NatThoPNS/Projet-Arduino/README.md

Bienvenue dans le GitHub de notre projet Arduino !
