NatThoPNS/Projet-Arduino/Rapports seances/Rapports Thomas/Rapport séance 4 12_01.pdf

## Projet Arduino: Maison connectée

## Rapport de séance n°4 (12/01/2022)

Par TORDJMAN BOLIS Thomas

- Problème ruban de LED

Aujourd’hui, je devais m’occuper du fonctionnement du volet roulant avec Nathan mais nous avions déjà fini la semaine dernière, entre-temps nous avons eu un problème avec le ruban de LED. 1 patte qui avait déjà été ressoudée s’est décrochée et une autre s’est aussi arrachée, j’ai donc demandé au professeur un autre morceau de ruban de LED.
J’ai mis du temps à le faire marcher car j’avais mal fait les branchements et je me suis rendu compte que 2 lignes de mon code précédent étaient inutile :

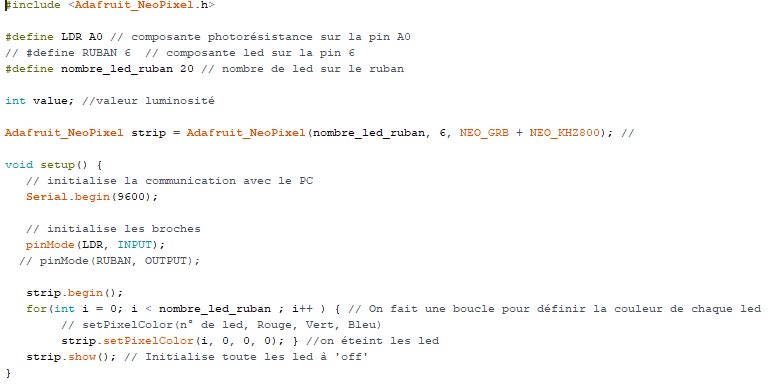
[picture p34: figure]

La variable RUBAN et la fonction pinMode(RUBAN,OUTPUT) sont inutiles car ils servent à attribuer la sortie numérique 6 au ruban mais en réalité, le deuxième argument (« 6 ») de la ligne de code ci-dessous sert déjà à ça.

- Maquette provisoire

En raison de l’oral intermédiaire, nous voulions présenter une maquette plus ou moins fonctionnelle. Nous avons donc décidé de mettre en place la carte arduino et tous les composants dans la maison en carton fabriquée la séance précédente.

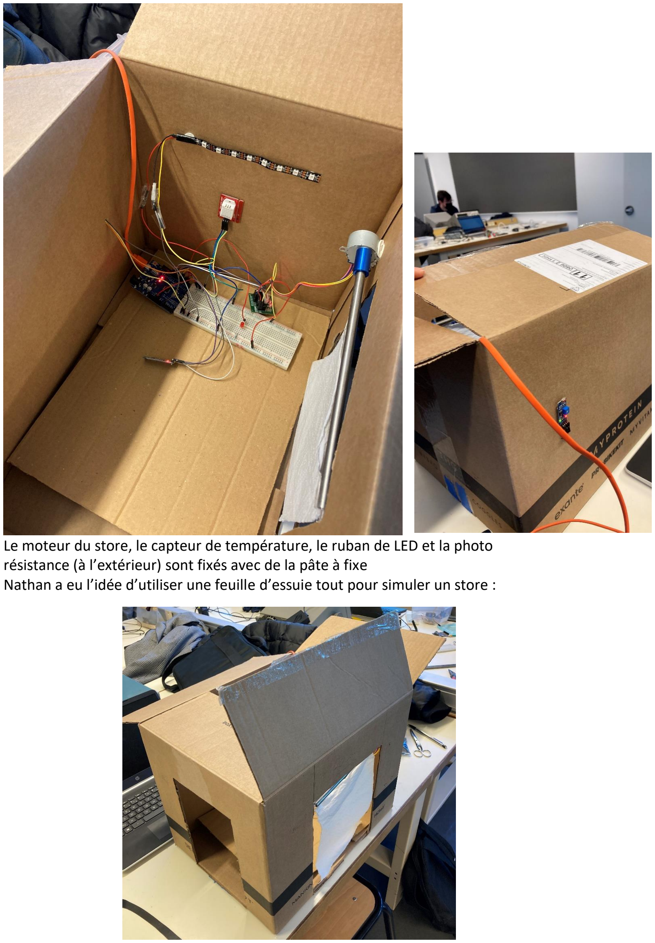
[picture p35: page 2]

Le moteur du store, le capteur de température, le ruban de LED et la photo résistance (à l’extérieur) sont fixés avec de la pâte à fixe
Nathan a eu l’idée d’utiliser une feuille d’essuie tout pour simuler un store :

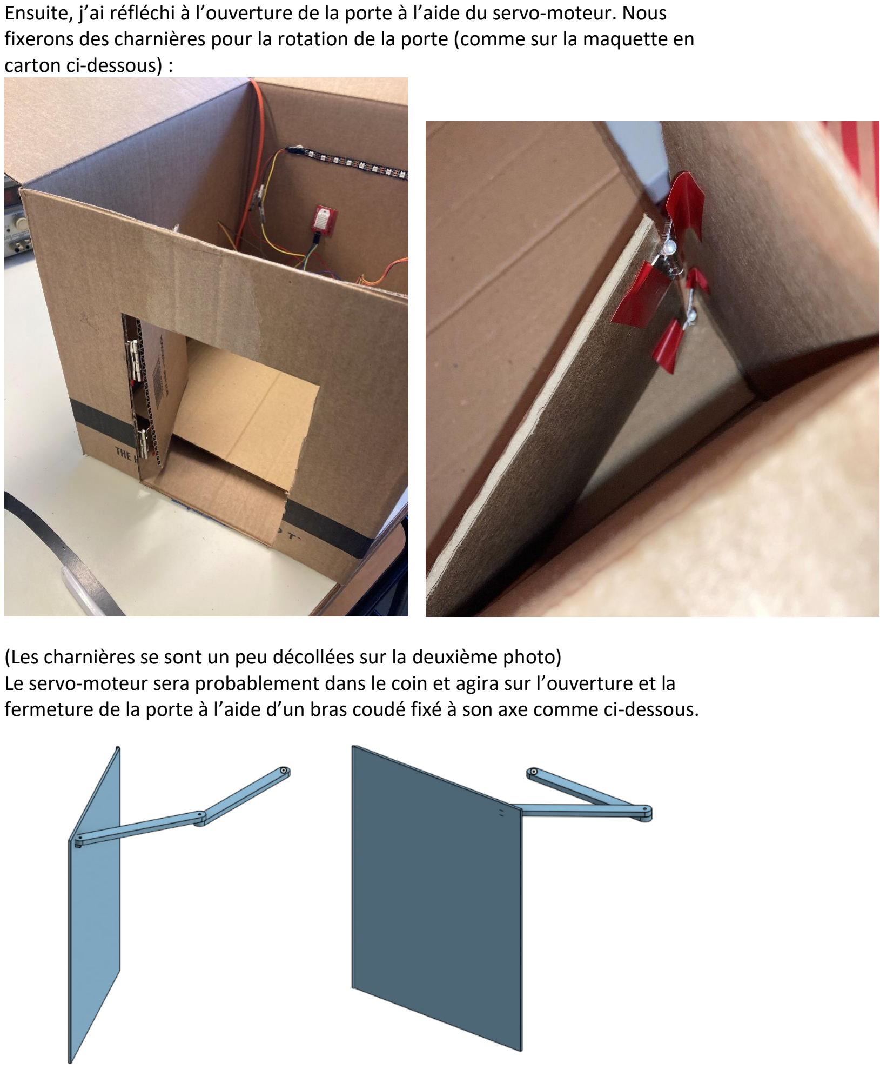
[picture p36: page 3]

Ensuite, j’ai réfléchi à l’ouverture de la porte à l’aide du servo-moteur. Nous fixerons des charnières pour la rotation de la porte (comme sur la maquette en carton ci-dessous) :

(Les charnières se sont un peu décollées sur la deuxième photo)
Le servo-moteur sera probablement dans le coin et agira sur l’ouverture et la fermeture de la porte à l’aide d’un bras coudé fixé à son axe comme ci-dessous.
