NatThoPNS/Projet-Arduino/Rapports seances/Rapports Thomas/Rapport séance 2 15_12.pdf

## Projet Arduino: Maison connectée

## Rapport de séance n°2 (15/12/2021)

Par TORDJMAN BOLIS Thomas

Aujourd’hui, pendant la majorité de la séance je me suis occupé du fonctionnement de l’éclairage de la maison avec le ruban de LED et le module photorésistance, j’ai aussi commencé a m’intéresser au fonctionnement du moteur pas à pas nécessaire au volet roulant.

- Eclairage de la maison :
1. Test du ruban de LED

Voici le code me permettant d’allumer mon ruban de LED en blanc :

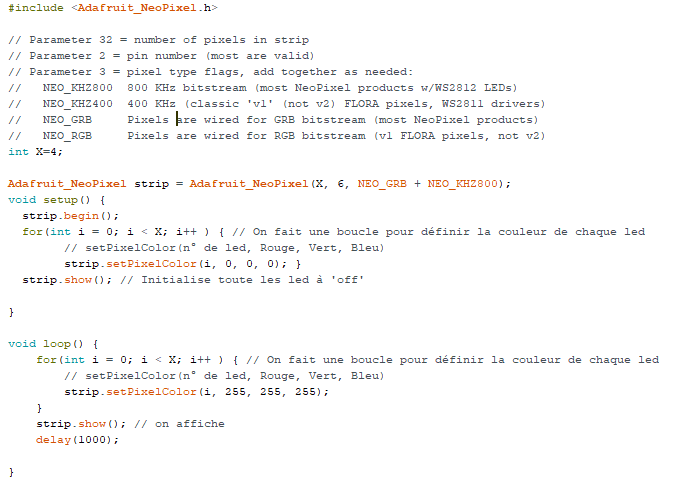
[picture p41: figure]

2. Test du module LDR

J’ai réalisé le montage suivant avec le code ci-dessous pour faire en sorte que la LED rouge s’allume lorsque la luminosité détectée par la LDR descend sous un certain seuil (ici en mettant le doigt sur la photorésistance).

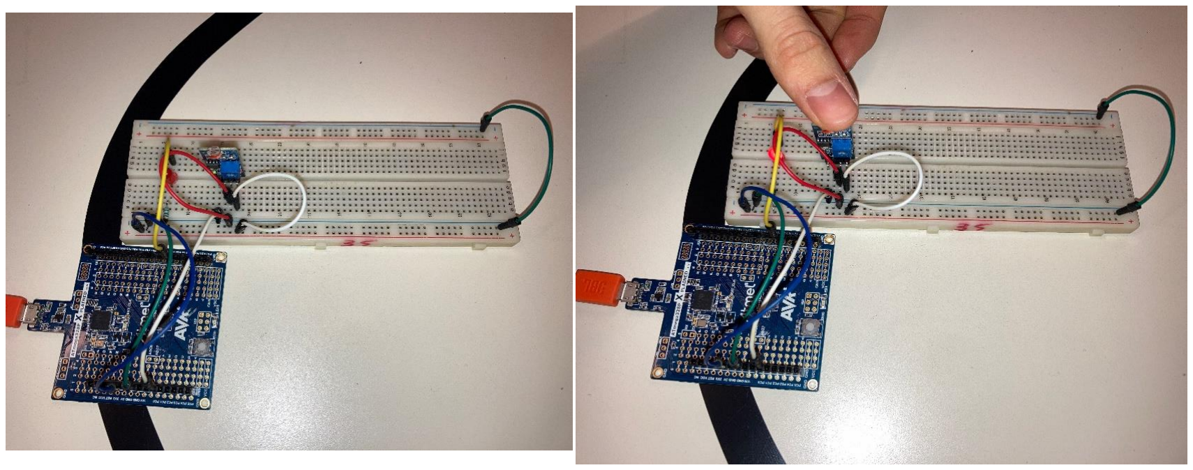
[picture p42: figure]
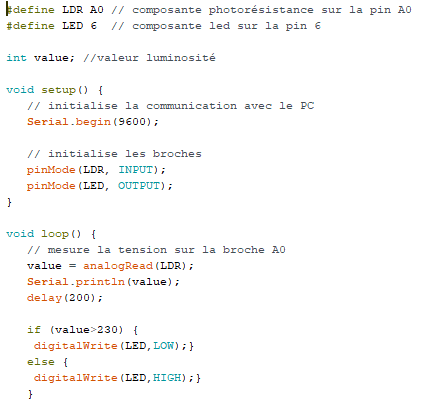
[picture p43: figure]

3. Test final LDR + ruban de LED

Ensuite, j’ai réalisé le montage suivant avec le code ci-dessous pour allumer le ruban de LED en blanc lorsque la luminosité détectée par la photorésistance descend sous un certain seuil (toujours en mettant le doigt dessus).
Le câble vert à droite reliant les deux lignes – est inutile, j’ai oublié de l’enlever après le montage précédent.

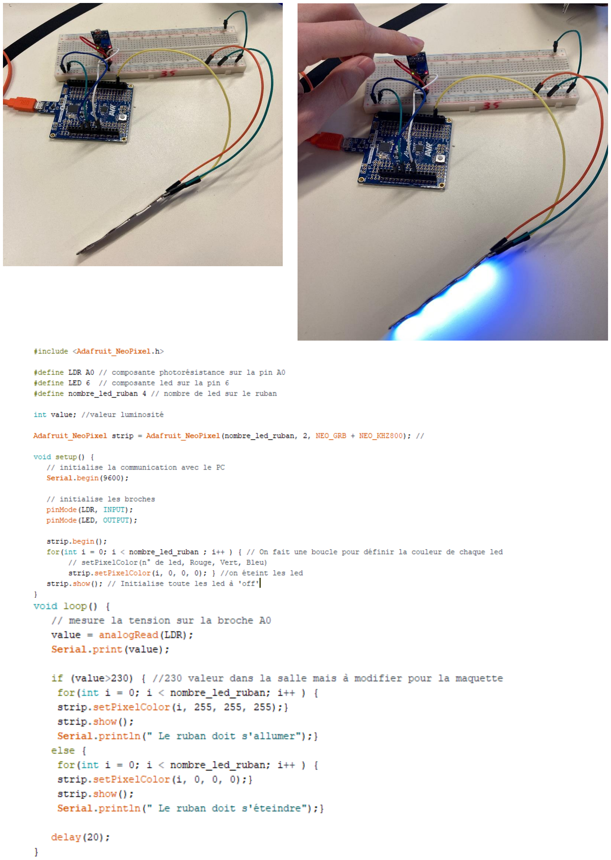
[picture p44: page 3]
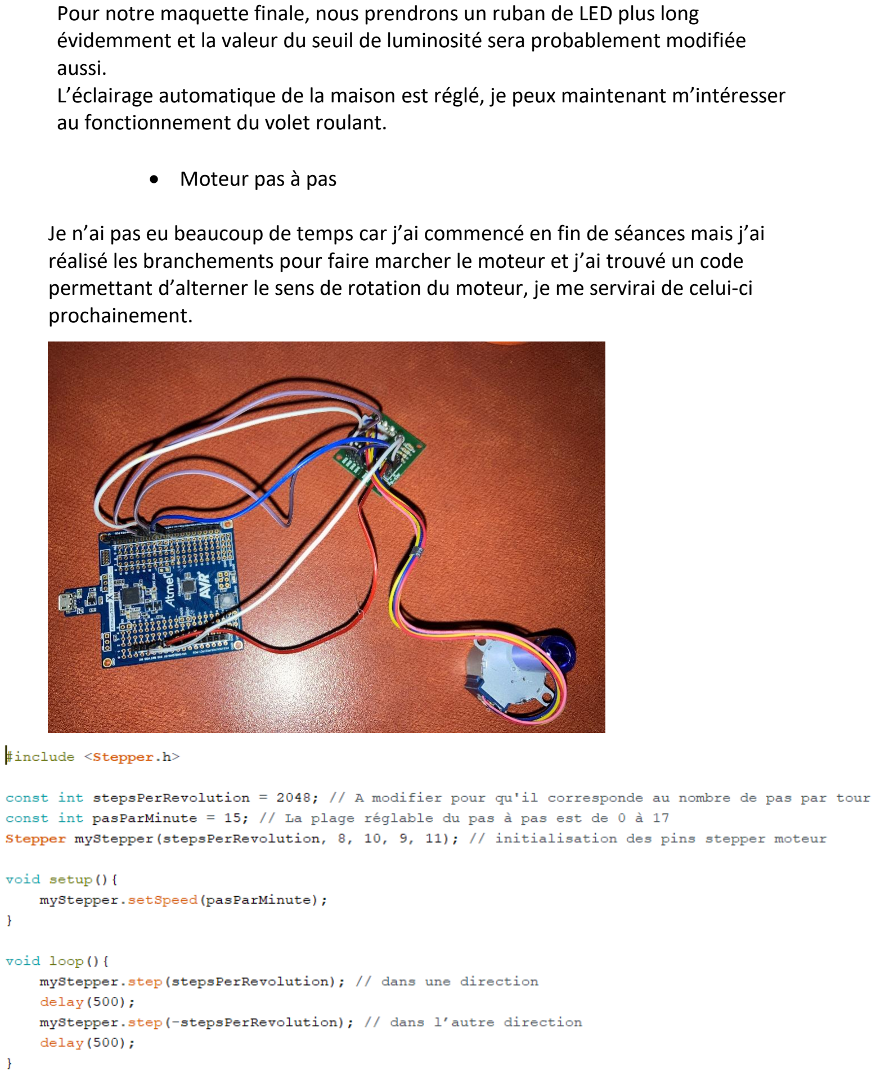
[picture p45: page 4]

Pour notre maquette finale, nous prendrons un ruban de LED plus long évidemment et la valeur du seuil de luminosité sera probablement modifiée aussi.
L’éclairage automatique de la maison est réglé, je peux maintenant m’intéresser au fonctionnement du volet roulant.
- Moteur pas à pas

Je n’ai pas eu beaucoup de temps car j’ai commencé en fin de séances mais j’ai réalisé les branchements pour faire marcher le moteur et j’ai trouvé un code permettant d’alterner le sens de rotation du moteur, je me servirai de celui-ci prochainement.
