NatThoPNS/Projet-Arduino/Rapports seances/Rapports Nathan/Rapport_2_du_15_12.pdf

# Projet Arduino: Maison connectée

## Rapport de séance n°2 (15/12/2021)

### Par Nathan PERDOUX

### - Partie 1: module Bluetooth HC-06

Je décide d'utiliser un autre module Bluetooth HC-06 identique au mien pour voir si le problème est dû au composant.
J'utilise le même code qu'à la dernière séance que voici:

#include<SoftwareSerial.h>

#define RX 11

#define TX 10

SoftwareSerial BlueT(RX,TX);

void setup() {
Serial.begin(9600);
delay(500);
Serial.println("Bonjour -Pret pour les commandes AT"); BlueT.begin(9600);
delay(500);
}

void loop() {
while (BlueT.available()) { Serial.print(char(BlueT.read())); } while (Serial.available()) { BlueT.write(char(Serial.read())); } }

Pour ce qui est du montage, je me suis rendu compte que j'avais fait une erreur en connectant la broche RX du module à l'I/O 11 de l'Arduino (que j'avais défini comme RX), idem pour TX alors qu'il faudrait relier RX du module au TX de l'Arduino et inversement...
Ci-dessous le montage mis à jour:

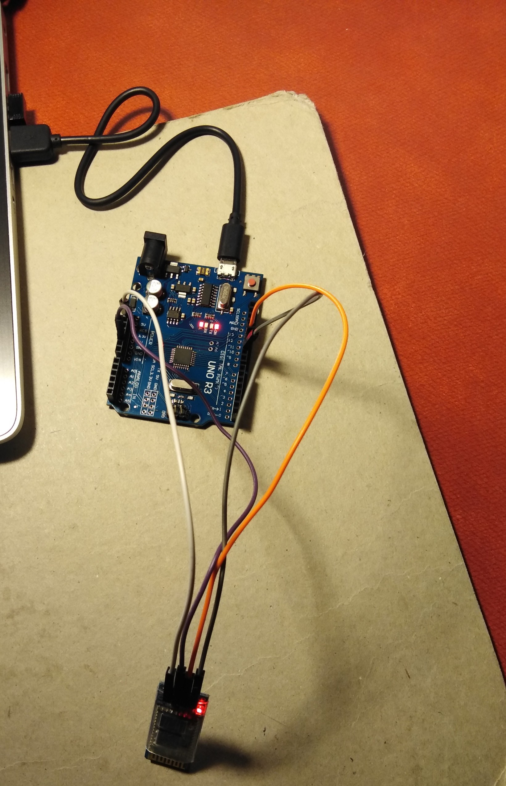
[picture p46: figure]
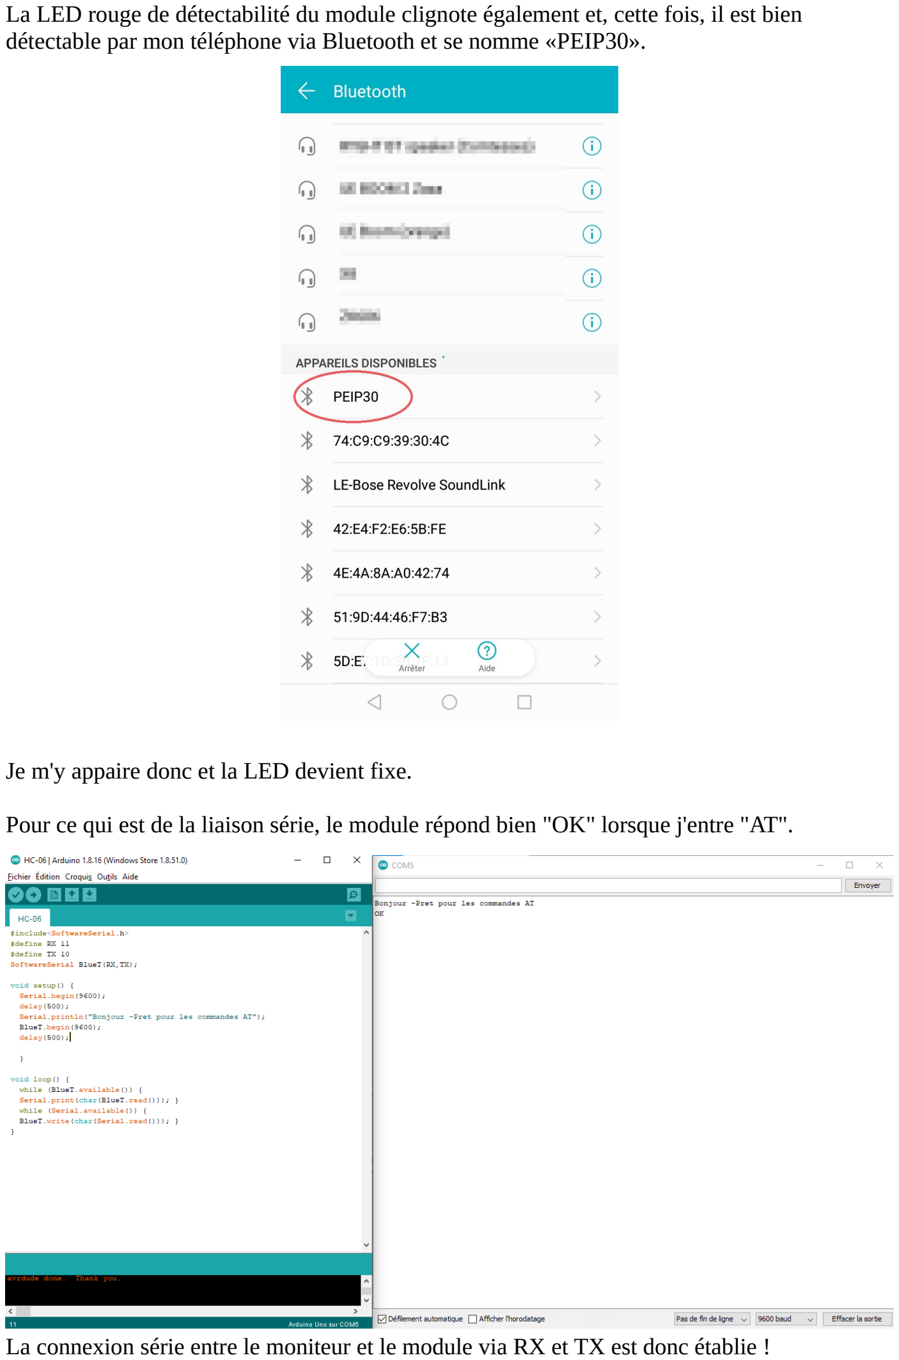
[picture p47: page 3]

La LED rouge de détectabilité du module clignote également et, cette fois, il est bien détectable par mon téléphone via Bluetooth et se nomme «PEIP30».

Je m'y appaire donc et la LED devient fixe.

Pour ce qui est de la liaison série, le module répond bien "OK" lorsque j'entre "AT".

La connexion série entre le moniteur et le module via RX et TX est donc établie !

À présent, j'utilise l'application Bluetooth Electronics sous Android disponible sur Play Store. (https://play.google.com/store/apps/details?id=com.keuwl.arduinobluetooth) Je devrai par la suite créer un panneau (panel sur l'application) afin de pouvoir commander les fonctionnalités de la maison au fil de notre projet (thermostat, volet, lumière, porte).

### - Partie 2: module AM2302 (capteur de température et d’hygrométrie)

Afin de respecter le planning, je me consacre à la partie «thermostat + chauffage». Nous songeons à remplacer le système de chauffage par un témoin de chauffe (LED) seulement car mettre en place un montage permettant effectivement d'augmenter la température de la maison de plusieurs degrés Celsius risque de s'avérer difficile avec Arduino.
Ainsi, je dois concevoir un montage permettant de mesurer la température ambiante. Pour cela j'ai à ma disposition le module AM2302 que voici:

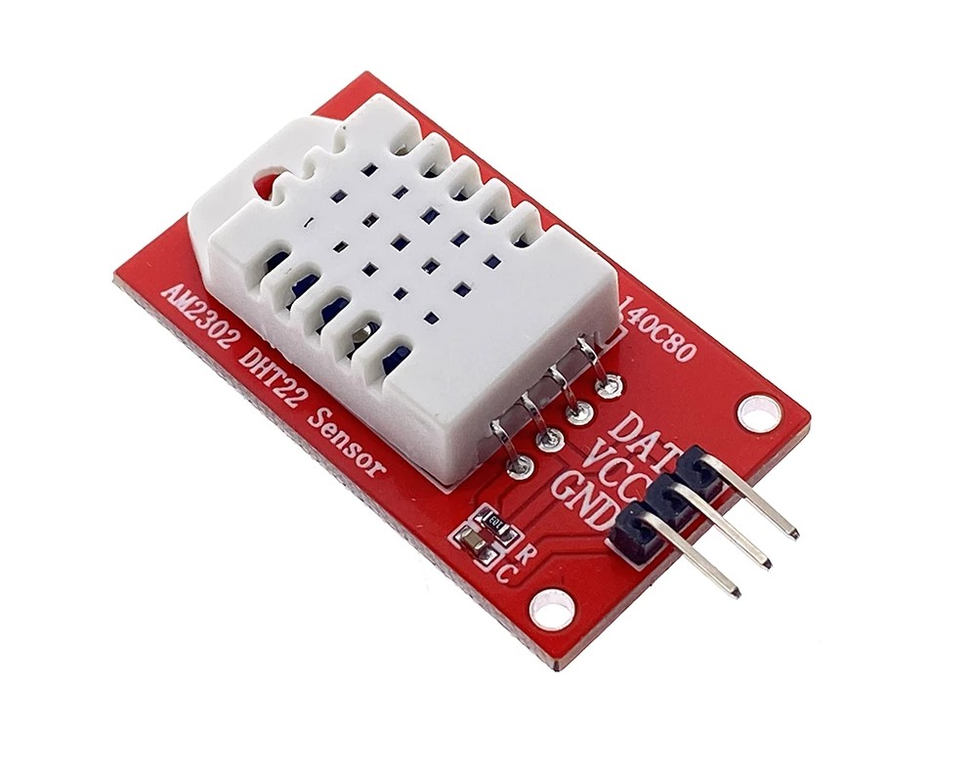
[picture p48: figure]

Ce module n'est autre qu'un capteur de température et d'humidité numérique haute précision. Il possède trois broches: VCC (5V), GND (masse), DAT (transfert de données de mesures). Après m'être renseigné sur Internet sur ce composant (code/montage) avec ce site francophone (http://projetsdiy.fr/mesure-humidite-temperature-capteur-dht11-dht22-arduino-raspberry/) et cette vidéo YouTube (http://youtu.be/oi_GPSLjgBY) en anglais par Robojax j'entreprends le câblage.

Voici le montage que j'utilise:

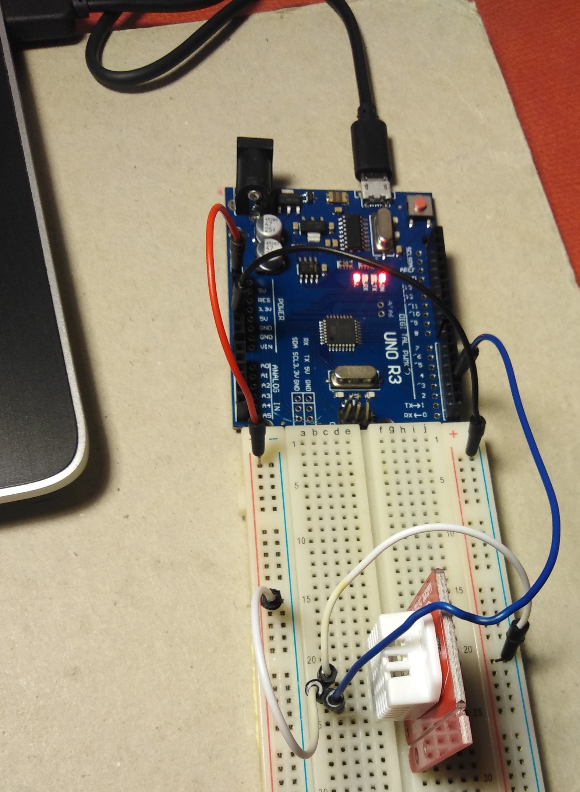
[picture p49: figure]

Le code que j'utilise est trouvable dans la description de la vidéo. (http://robojax.com/node/894) Vous le trouverez ici, (https://github.com/NatThoPNS/Projet-Arduino/commit/735a8c4ab826cfc9cd799e0233f26327934f8850?diff=unified) sur le GitHub de notre projet.
Il faut également installer une bibliothèque nommée DHT qui permet d'utiliser l'AM2302. La procédure d'installation est détaillée dans la vidéo.

Cela fonctionne bien, la température s'affiche dans le moniteur série (en K, °C et °F) tout comme l'humidité (en %).

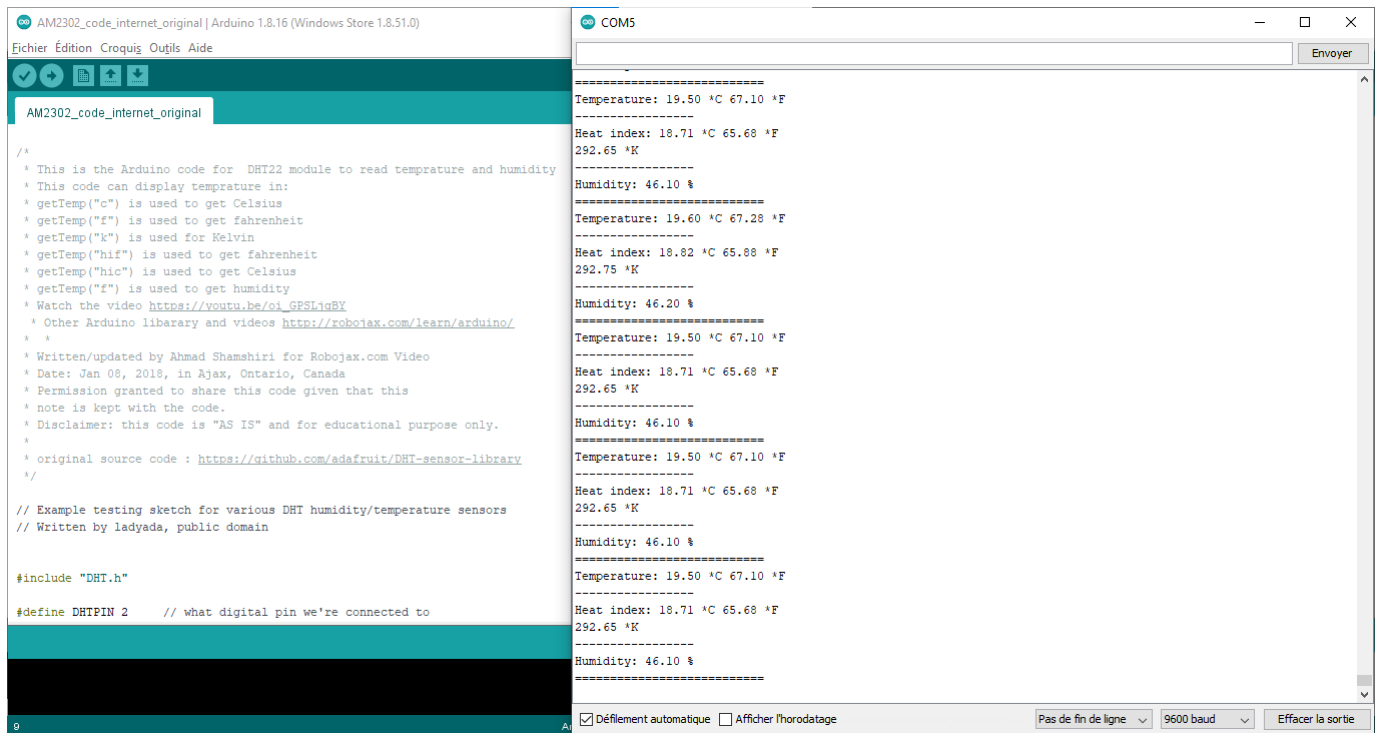
[picture p50: figure]

Je ne peux pas faire varier la température en salle de TP mais je fais varier l'humidité en plaçant mon doigt sur le module (partie blanche quadrillée), l'humidité mesurée augmente comme prévu.

Je décide alors d'ajouter une LED à mon montage qui s'allume lorsque l'humidité dépasse un certain seuil que je fixe, par exemple 50%.
Le code mis à jour est trouvable ici (https://github.com/NatThoPNS/Projet-Arduino/blob/main/Rapports%20seances/Rapports%20Nathan/Compl%C3%A9ments%2015_12/AM2302_LED_hygrometrie.ino) et voici le montage comprenant la LED de seuil:

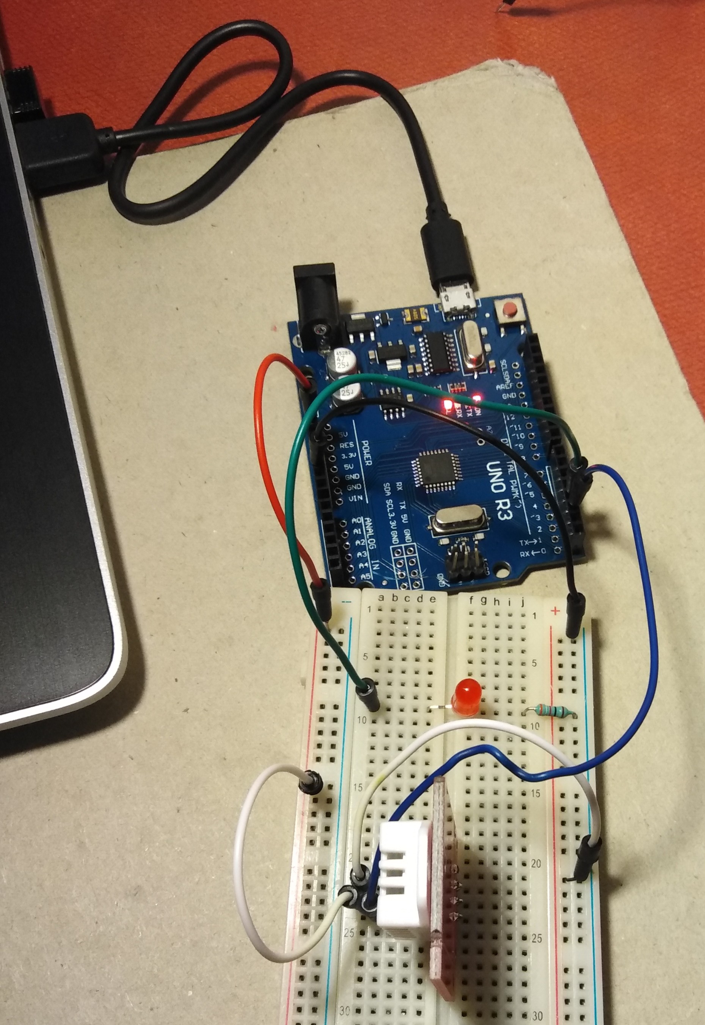
[picture p51: figure]

Je constate que la LED s'allume bien lorsque je place mon doigt sur la partie blanche du module et que l'hygrométrie augmente, atteignant et dépassant 50%.

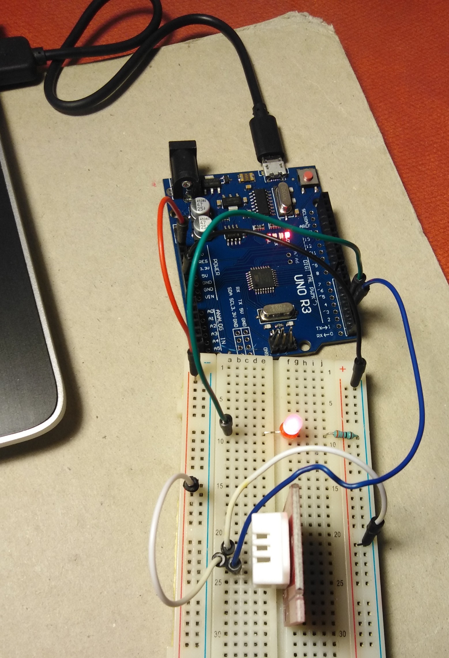
[picture p52: figure]

Il ne me reste plus qu'à fixer un seuil pour la température et non pour l'hygrométrie et de tester si tout fonctionne lorsque je fais en sorte que la température dépasse le seuil. J’ai fixé le seuil à 20°C, le code correspondant est trouvable ici. (https://github.com/NatThoPNS/Projet-Arduino/blob/main/Rapports%20seances/Rapports%20Nathan/Compl%C3%A9ments%2015_12/AM2302_LED_temperature.ino) Je place le module à proximité d’une lampe de bureau chaude et je constate que la LED s’allume bien une fois le seuil dépassé.
