NatThoPNS/Projet-Arduino/Planning.pdf

## Projet Arduino : Maison connectée Planning d’avancement

Par PERDOUX Nathan et TORDJMAN-BOLIS Thomas (G3)

1. Planning
Semaine | 48 | 50 | 1 | 2 | 5 | 6 | 8 | 9

Liaison Bluetooth
Eclairage à LED
Thermostat + chauffage

Volet roulant
Verrouillage de la porte

Maison
Assemblage maquette finale + finitions

Légende :
Thomas

Nathan

Nathan et Thomas
