NatThoPNS/Projet-Arduino/Rapports seances/Rapports Thomas/readme.md

Ce répertoire contient les rendus de séance de Thomas TORDJMAN du G3.
