NatThoPNS/Projet-Arduino/Rapports seances/Rapports Nathan/Compléments 31_01/readme.md

Ce répertoire contient les fichiers complémentaires de la séance 5 du 31/01/2022.
