NatThoPNS/Projet-Arduino/Rapports seances/Rapports Nathan/Compléments 12_01/readme.md

Ce répertoire contient les fichiers complémentaires de la séance 4 du 12/01/2022.
