NatThoPNS/Projet-Arduino/Rapports seances/Rapports Nathan/Compléments 05_01/readme.md

Ce répertoire contient les fichiers complémentaires de la séance 3 du 05/01/2022.
