NatThoPNS/Projet-Arduino/Rapports seances/Rapports Nathan/Compléments 15_12/readme.md

Ce répertoire contient les fichiers complémentaires de la séance 2 du 15/12/2021.
