NatThoPNS/Projet-Arduino/Rapports seances/Rapports Nathan/Compléments 01_12/readme.md

Ce répertoire contient les fichiers complémentaires de la séance 1 du 01/12/2021.
