NatThoPNS/Projet-Arduino/Rapports seances/Rapports Nathan/Compléments 28_02/readme.md

Ce répertoire contient les fichiers complémentaires de la séance 8 du 28/02/2022.
