NatThoPNS/Projet-Arduino/Rapports seances/Rapports Nathan/Compléments 01_12/Montage_01_12.pdf

Projet Arduino: Maison connectée

Photos montage (01/12/2021)

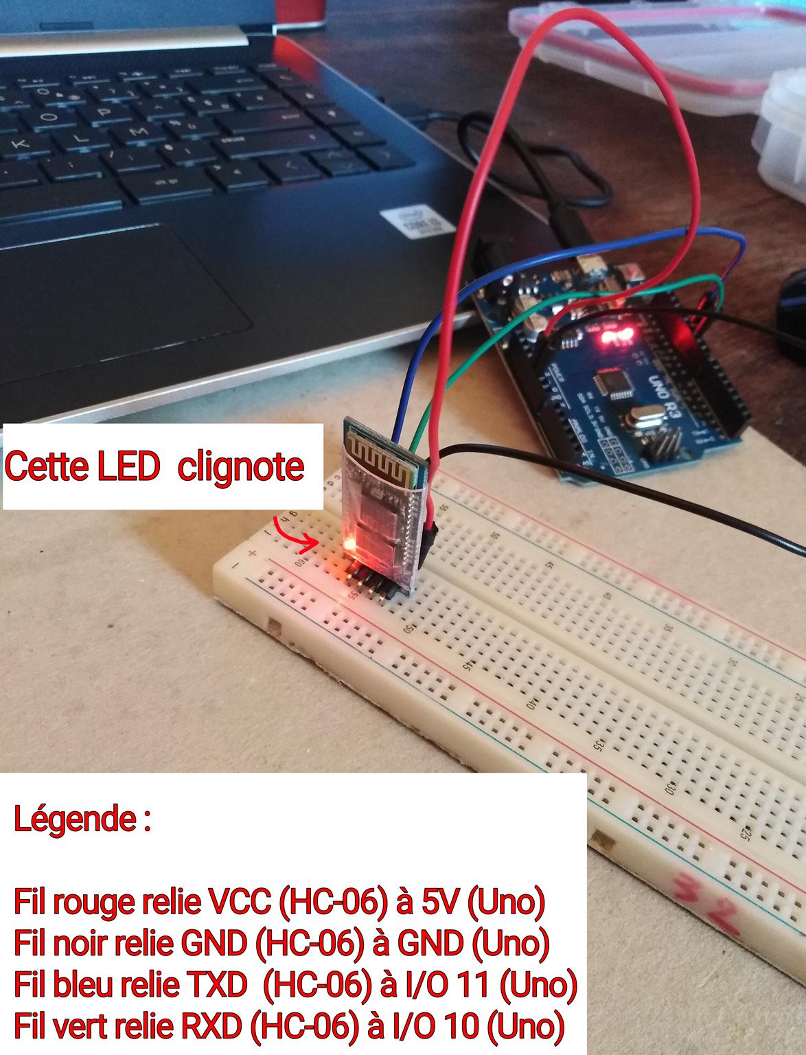
[picture p69: figure]

Par Nathan PERDOUX

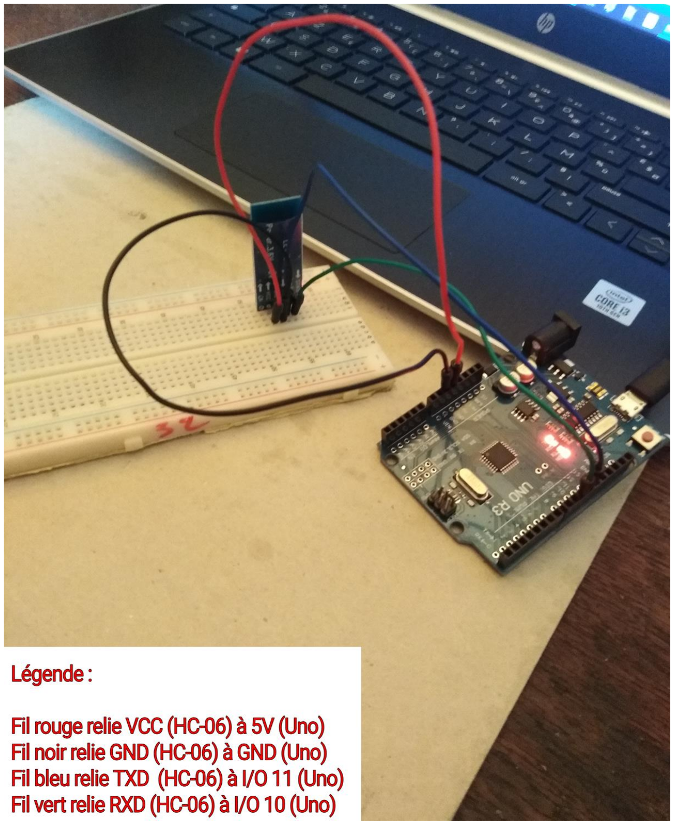
[picture p70: figure]
