NatThoPNS/Projet-Arduino/DIAPO ORAL.pdf

# La maison

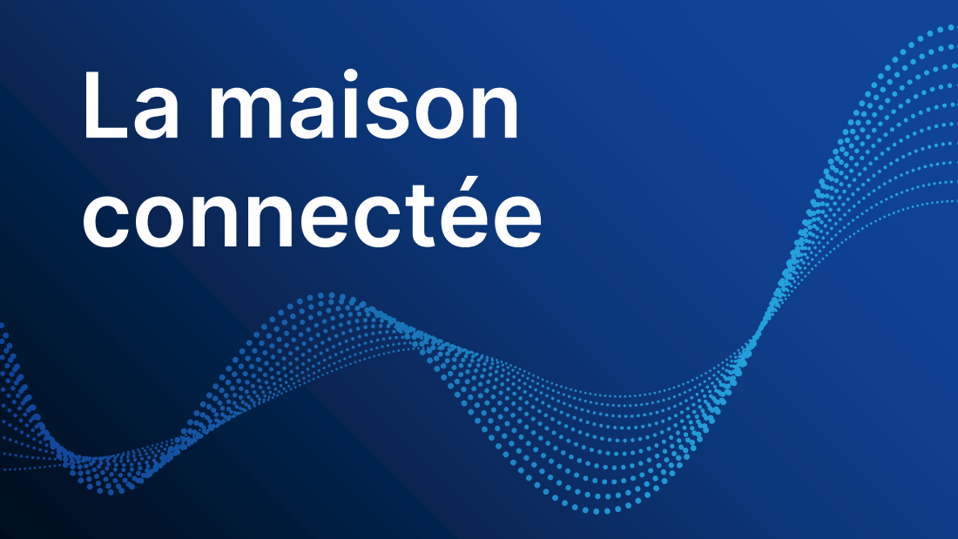
[picture p71: page 1]
connectée

## Introduction

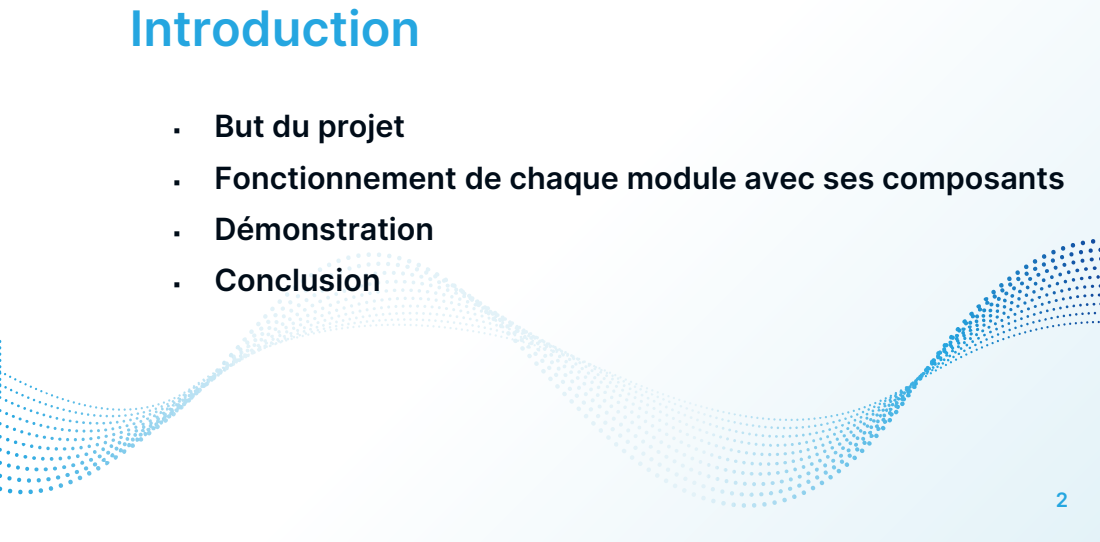
[picture p72: page 2]

▪ But du projet
▪ Fonctionnement de chaque module avec ses composants
▪ Démonstration
▪ Conclusion

## But du projet

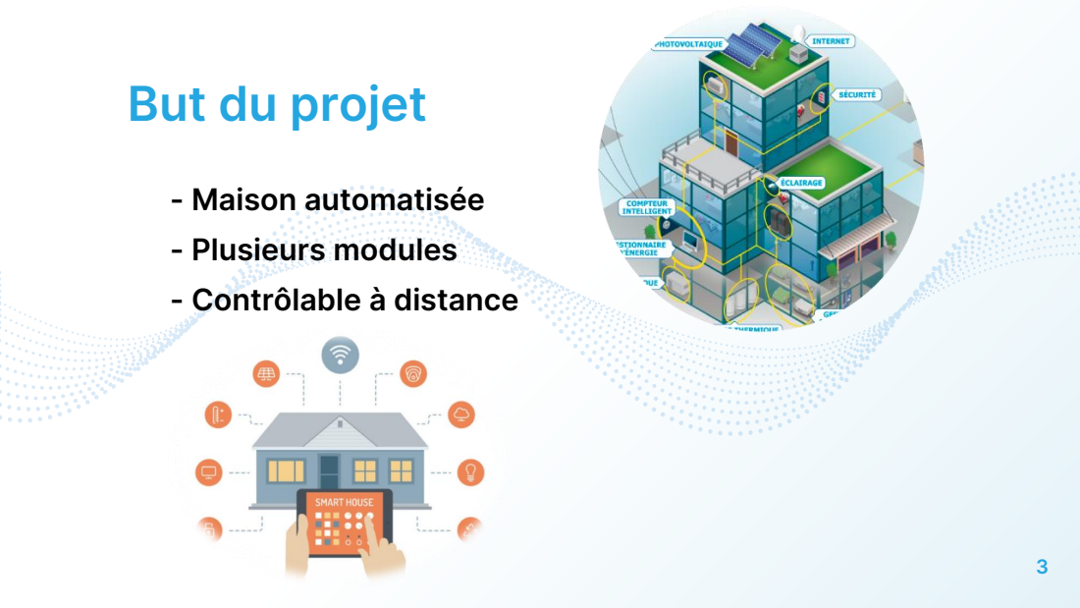
[picture p73: page 3]
- Maison automatisée - Plusieurs modules - Contrôlable à distance

## Fonctionnement des modules

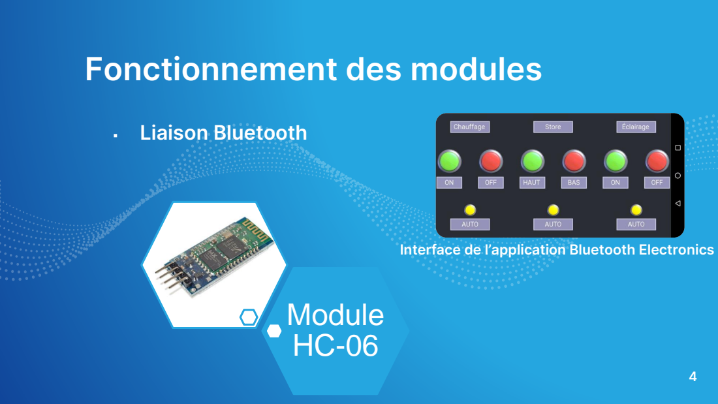
[picture p74: page 4]
Module HC-06; ▪ Liaison Bluetooth

Interface de l’application Bluetooth Electronics

## Fonctionnement des modules

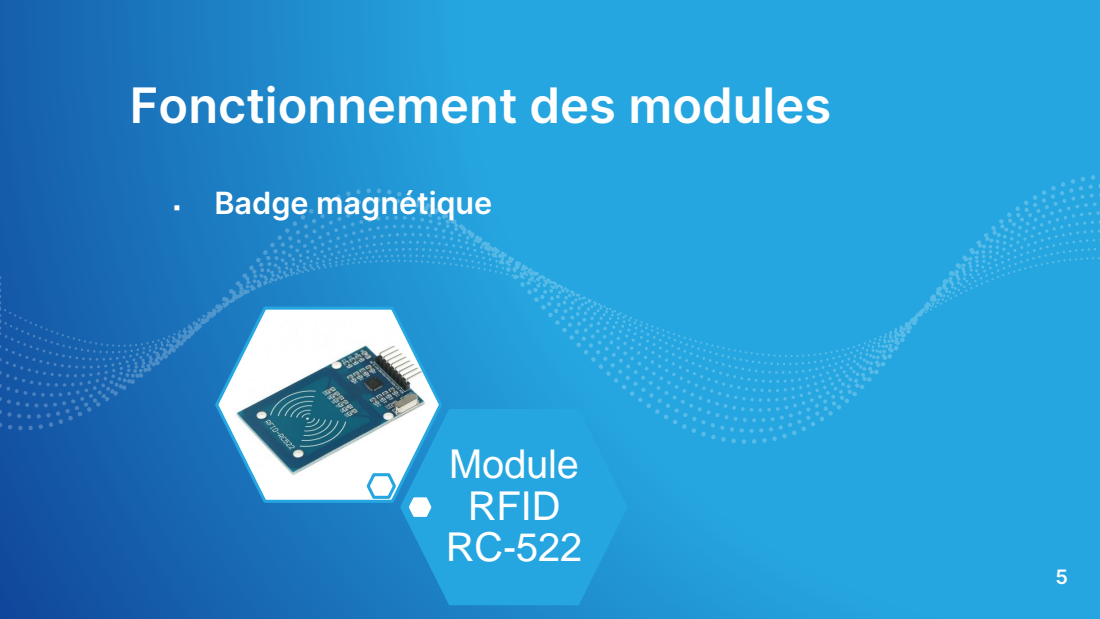
[picture p75: page 5]
▪ Badge magnétique; Module RFID RC-522

## Fonctionnement des modules

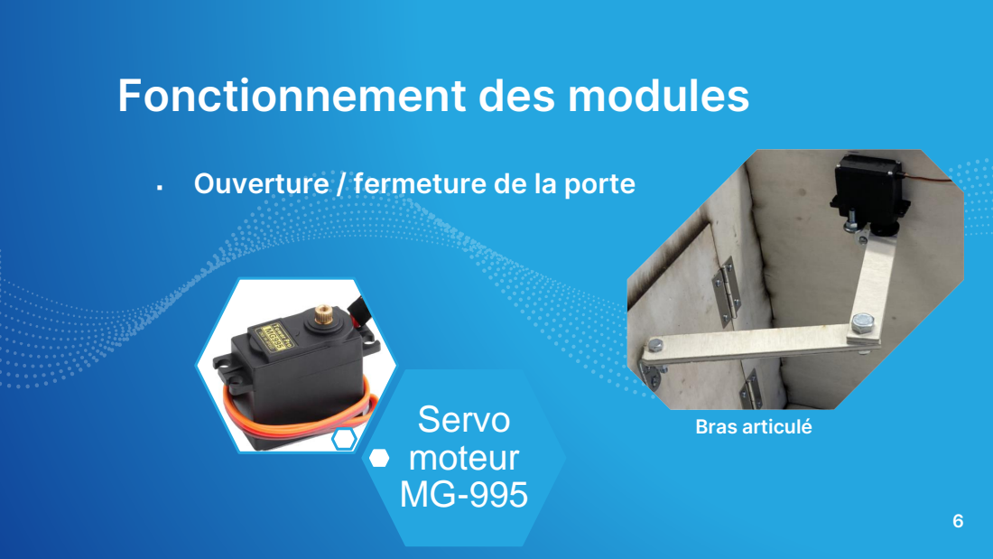
[picture p76: page 6]
Servo moteur MG-995; Bras articulé

▪ Ouverture / fermeture de la porte

## Fonctionnement des modules

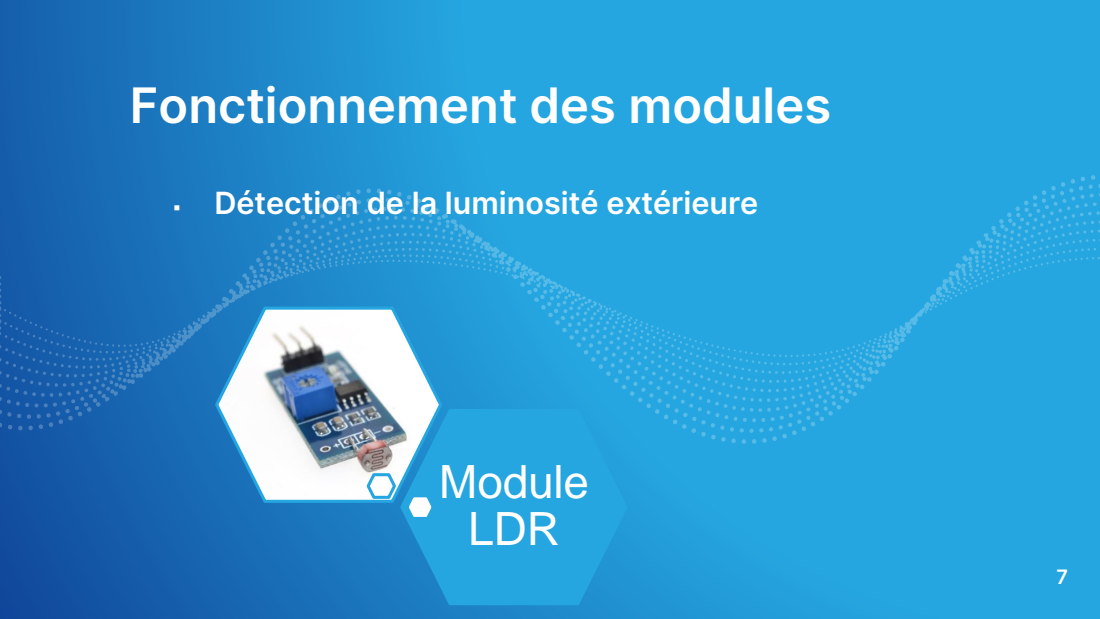
[picture p77: page 7]
Module LDR

▪ Détection de la luminosité extérieure

## Fonctionnement des modules

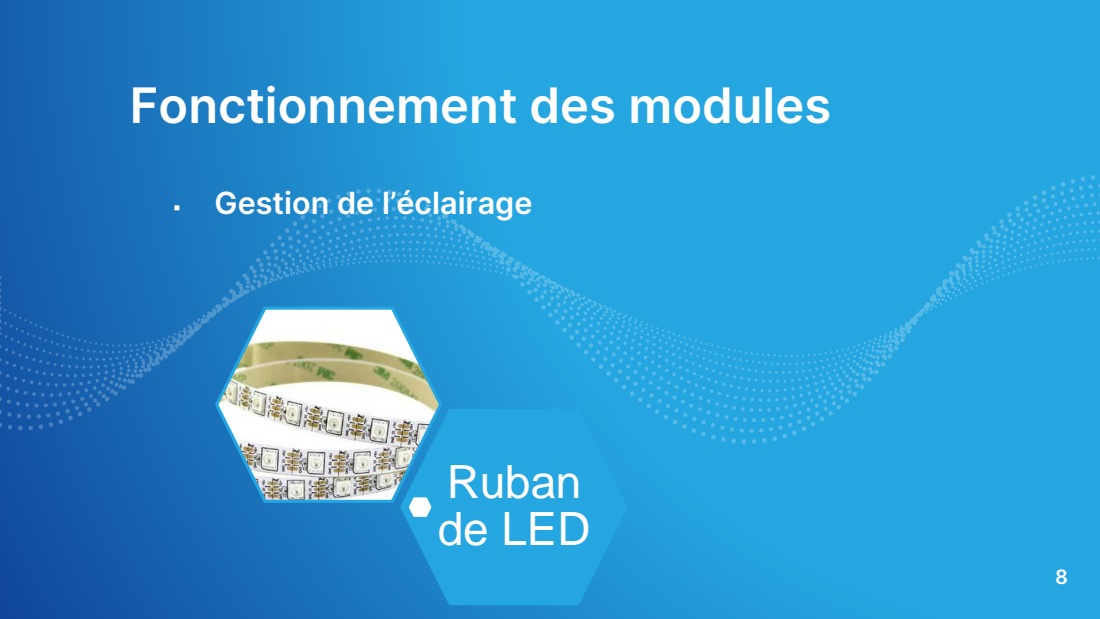
[picture p78: page 8]
Ruban de LED

▪ Gestion de l’éclairage

## Fonctionnement des modules

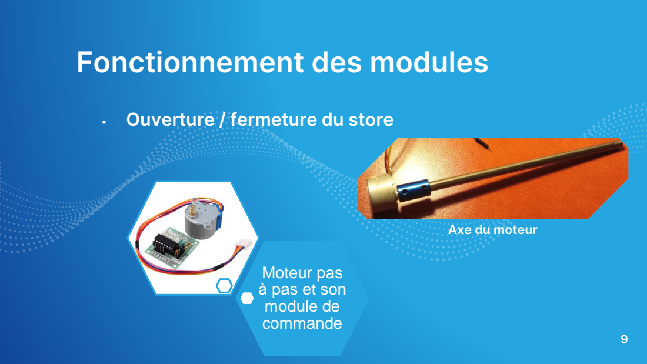
[picture p79: page 9]

▪ Ouverture / fermeture du store

Axe du moteur

Moteur pas
à pas et son
module de
commande

## Fonctionnement des modules

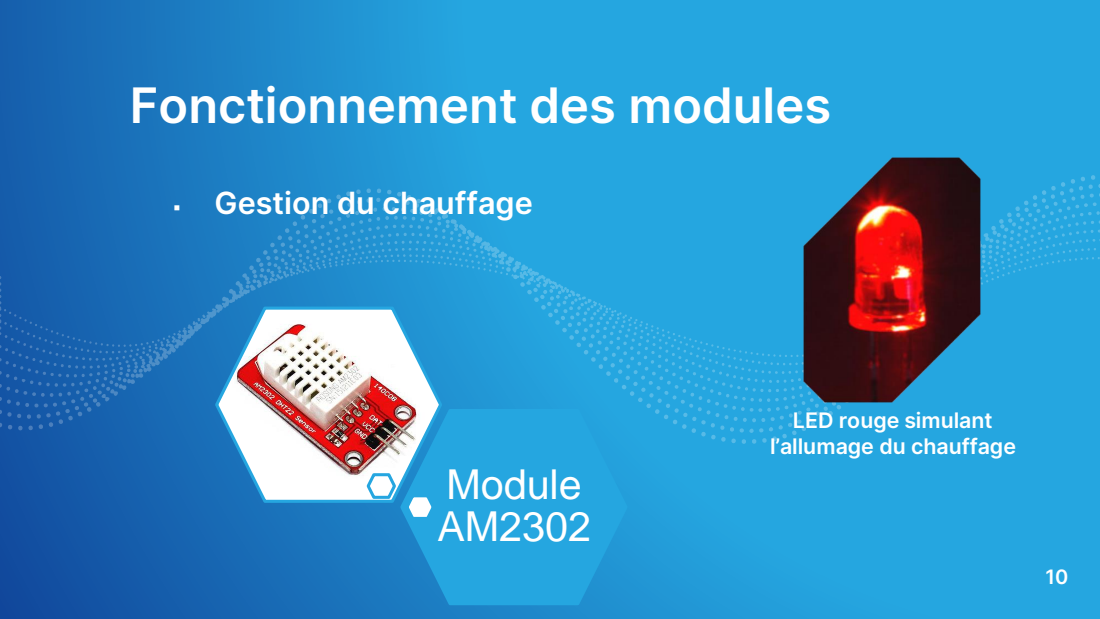
[picture p80: page 10]
Module AM2302

▪ Gestion du chauffage

LED rouge simulant
l’allumage du chauffage

## Démonstration

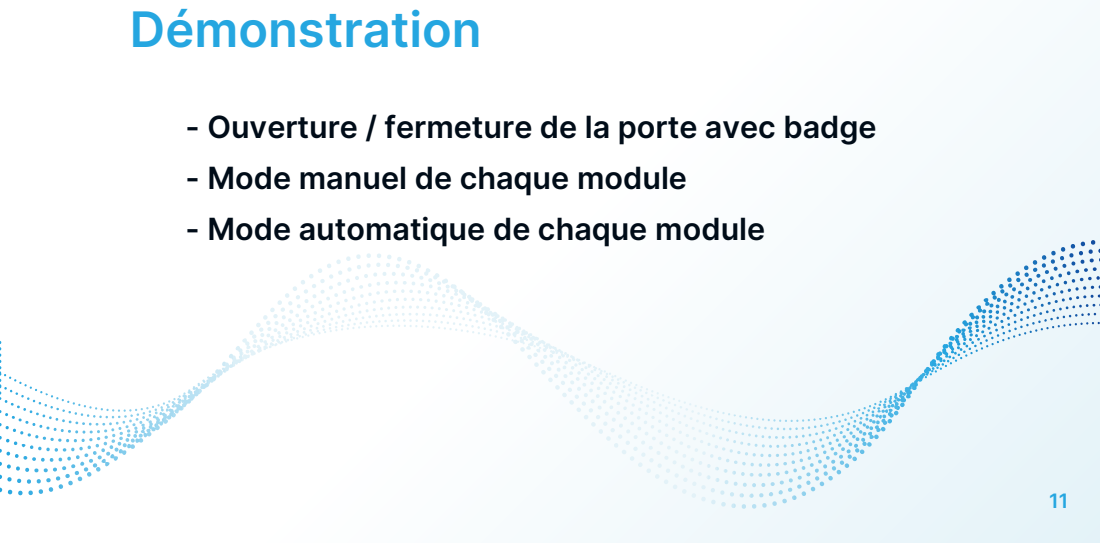
[picture p81: page 11]

- Ouverture / fermeture de la porte avec badge
- Mode manuel de chaque module
- Mode automatique de chaque module

## Conclusion

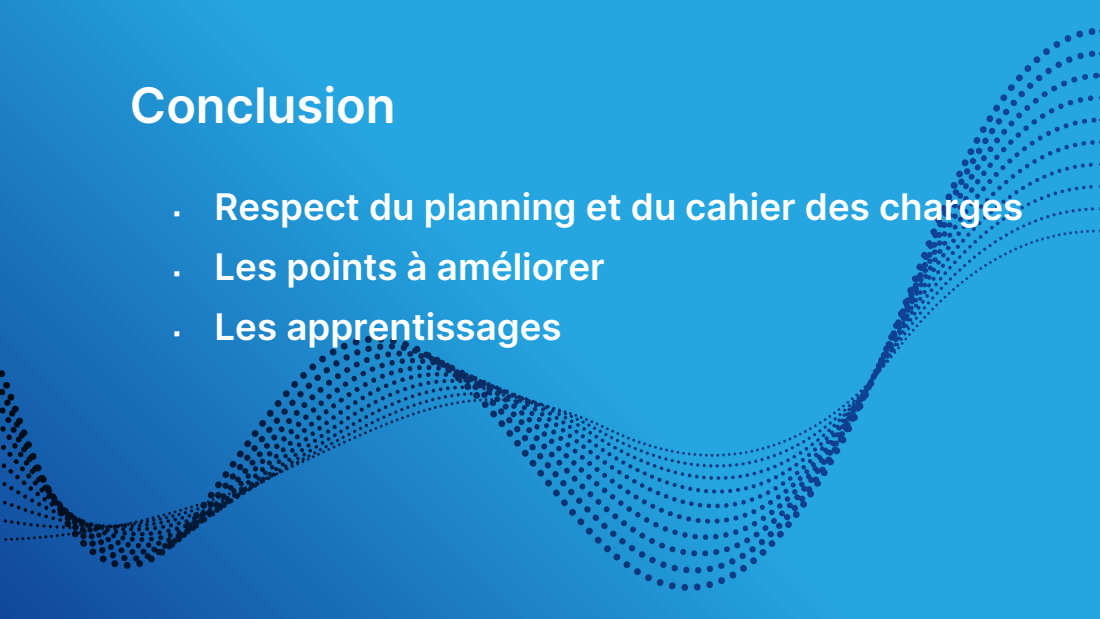
[picture p82: page 12]

▪ Respect du planning et du cahier des charges
▪ Les points à améliorer
▪ Les apprentissages

# La maison
